claudiocapone39/Buck_Converter_20V_5V/README.md

# Synchronous Buck Converter 10-20V to 5V

This Synchronous Buck converter takes 10-20V range as input voltage and outputs 5A@5V. 
It features an LCD screen to show information and a user button to interact with the device.
The board features an LPC1313 NXP Microcontroller in addition with a buffer stage and RC filter for noise attenuation.

Buck_Converter_PCB_isometric

Buck_Converter_Block_Schematic

<br>

## SIMETRIX
  
  The converter has been simulated through the use of SIMETRIX software. 
  In this schematic, the PWM signals from the MCUs have been implemented as ideal pulse generators (INA and INB)
  
  <br>
  
  Buck_Converter_Synchronous_20V_Simetrix

  <br>

  - UCC27282 is the Gate Driver of the MOSFETs RSS065N06HZG
  - LP38691 is the LDO that outputs 3.3V
  - OPA827 works both as a buffer for the voltage divider signal and as an RC filter

The output of the buck converter, after a short transient, gets stable at 5V.

<br>

Buck_Converter_VOUT

<br>

The output of the op-amp is the voltage reference for the MCU's ADC. After a short transient, it gets stable at 3.3V

Buck_Converter_X1-OUT

<br>

The converter's efficiency has been evaluated as the ratio between output and input power.

<br>

Buck_Converter_Efficiency_report

## PCB
The PCB has been designed in Autodesk Fusion 360


Buck_Converter_PCB_top
Buck_Converter_PCB_bottom
