claudiocapone39/Buck_Converter_20V_5V/images/Buck_Converter_PCB_top.png

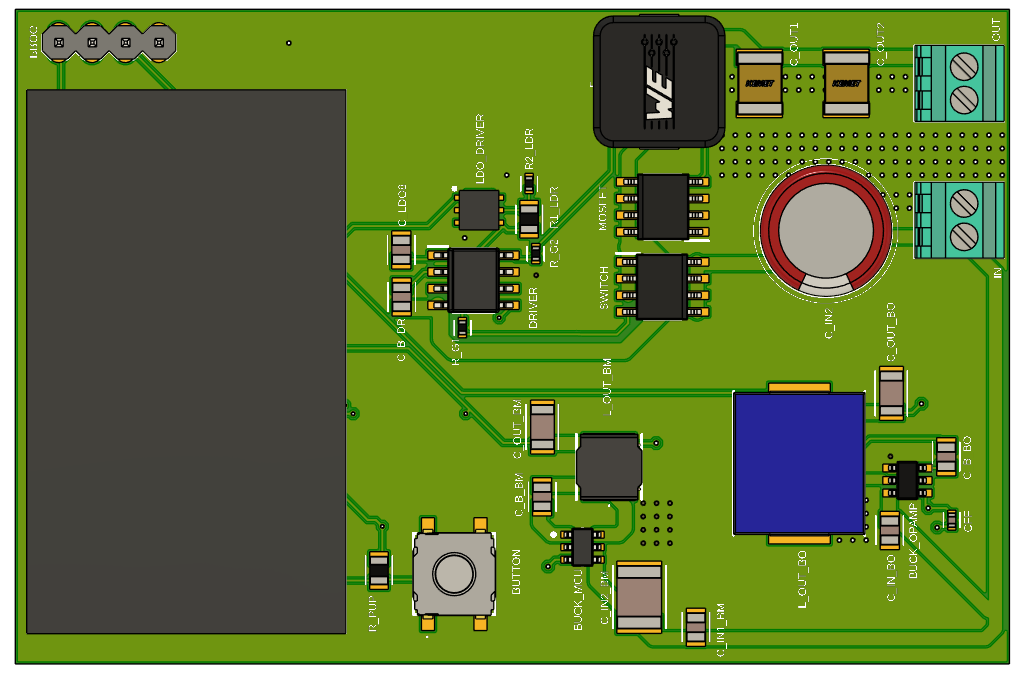
images/Buck_Converter_PCB_top.png
