claudiocapone39/Buck_Converter_20V_5V/images/Buck_Converter_Synchronous_20V_Simetrix.png

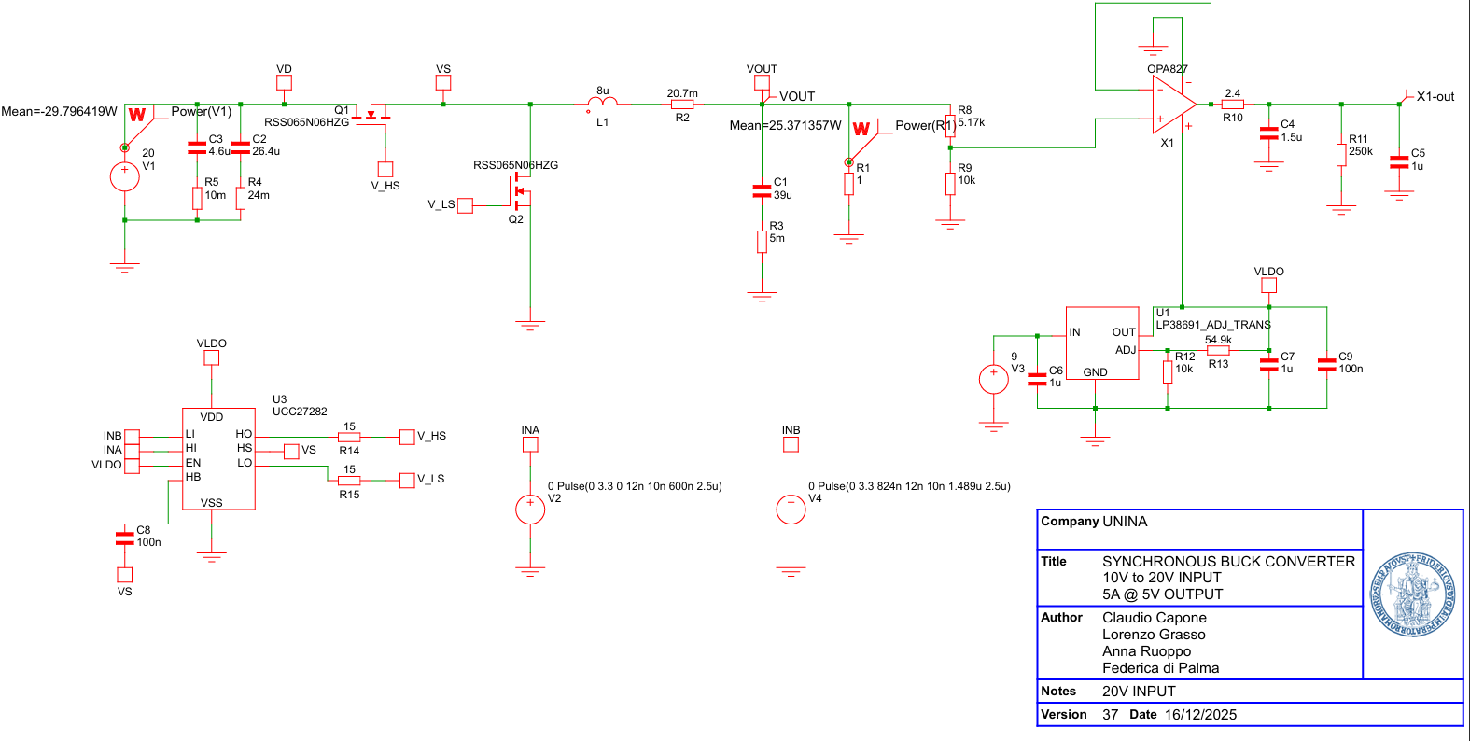
images/Buck_Converter_Synchronous_20V_Simetrix.png
