claudiocapone39/Buck_Converter_20V_5V/images/Buck_Converter_VOUT.png

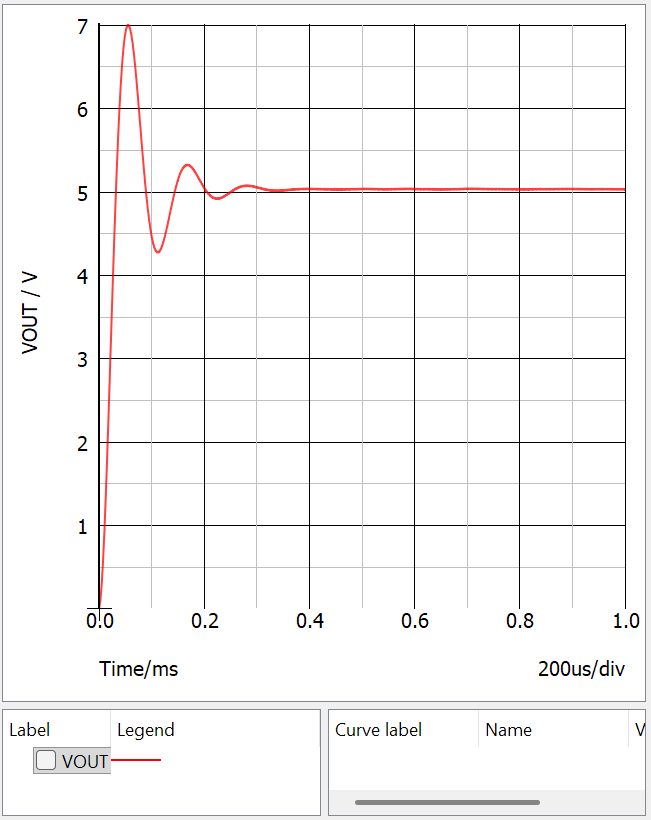
images/Buck_Converter_VOUT.png
