claudiocapone39/Buck_Converter_20V_5V/images/Buck_Converter_X1-OUT.png

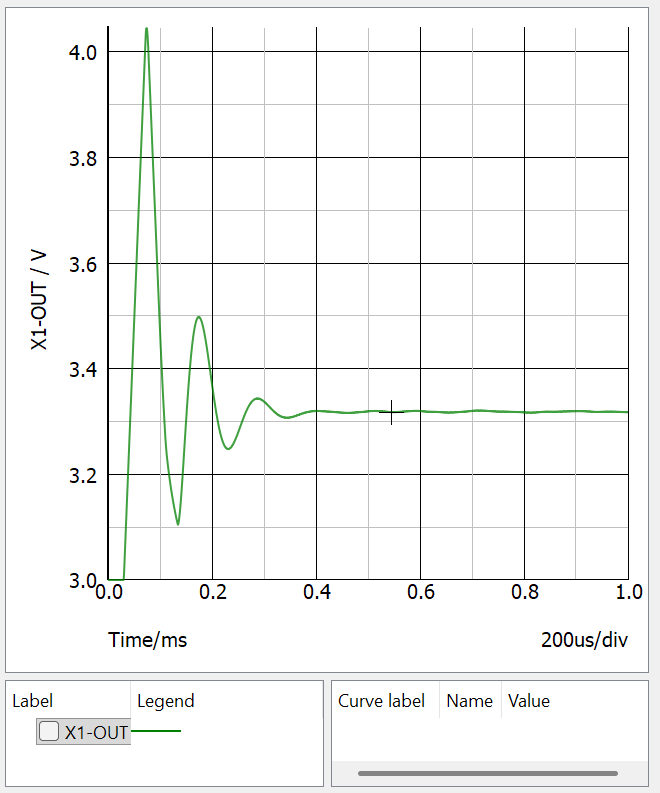
images/Buck_Converter_X1-OUT.png
