claudiocapone39/Buck_Converter_20V_5V/images/Fusion_Schematic/BUCK.png

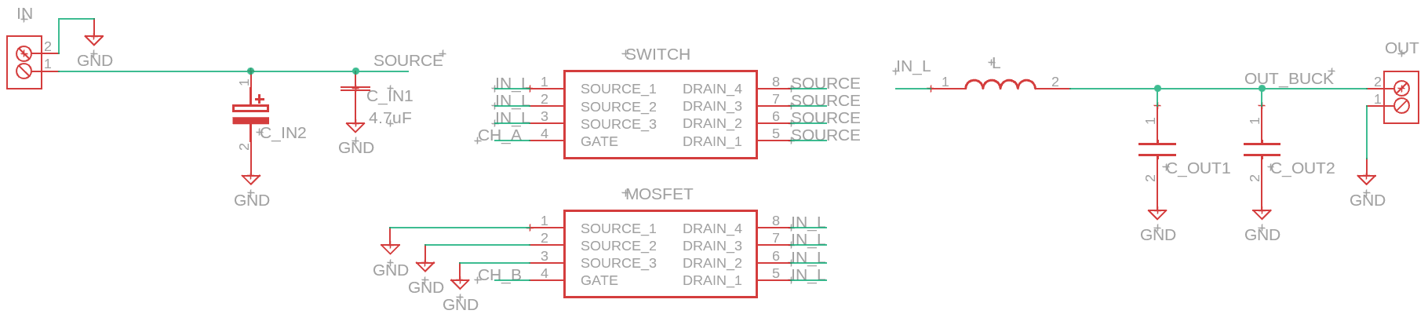
images/Fusion_Schematic/BUCK.png
