claudiocapone39/Buck_Converter_20V_5V/images/Fusion_Schematic/OPAMP.png

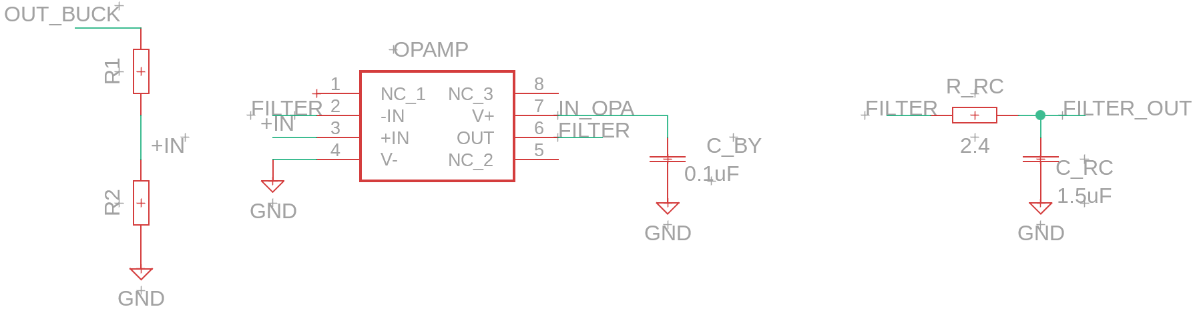
images/Fusion_Schematic/OPAMP.png
