claudiocapone39/Buck_Converter_20V_5V/BOM/BUCK_BOM.xlsx

PART NUMBER | INFO | CATEGORY | VALUE | TOLLERANCE | R | MATERIAL | QUANTITY | SELLER | PRICE
744331000 (https://www.mouser.it/ProductDetail/EPCOS-TDK/B82559B7103A016?qs=hWgE7mdIu5T7T698J9srCw%3D%3D) | Power inductor | INDUCTOR | L=10uH | NA | 20.7 mΩ | Ferite Core | 1 | Mouser | 3.61 €
RSS065N06HZGTB (https://www.mouser.it/ProductDetail/ROHM-Semiconductor/RSS065N06HZGTB?qs=XAiT9M5g4x%252BYRKVmXrwbMA%3D%3D) | Switching Mosfet | MOSFET | Id=6.5 A, Vds=60V | N.A. | 37mΩ | Silicon | 2 | Mouser | 1.78 €
C1812C206K3RLCAUTO (https://www.mouser.it/ProductDetail/KEMET/C1812C206K3RLCAUTO?qs=W%2FMpXkg%252BdQ4s7ay3ZQXJwQ%3D%3D) | Output Capacitor | CAPACITOR | C=20 uF | 10% | low ESR | Ceramic | 2 | Mouser | 3.95 €
C1812J475K5RACAUTO (https://www.mouser.it/ProductDetail/KEMET/C1812J475K5RACAUTO?qs=1Kr7Jg1SGW%252B18uJQlTRv8w%3D%3D) | Input Capacitor | CAPACITOR | C=4.7uF | 0.1 pF | low ESR | Ceramic | 1 | Mouser | 1.47 €
870235675002 (https://www.mouser.it/ProductDetail/Wurth-Elektronik/870235675002) | Input Capacitor | CAPACITOR | C=33uF | 20% | 24mΩ | Alluminum Electrolytic | 1 | Mouser | 1.08 €
TE 282834-2 (https://it.rs-online.com/web/p/morsetti-pcb/7100104?cm_mmc=aff2-_-it-_-octopart-_-7100104-_-instock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) | Morsettiera 2 pin | CONNECTOR | Vmax=150V, Imax=10A |  |  |  | 2 | RS | 2.60 €
 |  |  |  |  |  |  |  |  | 14.49 €
FSV540 (https://www.mouser.it/ProductDetail/onsemi-Fairchild/FSV540?qs=bY1dm4K8r4Uyd0P0StXc%2FQ%3D%3D) | Schottky Diode | DIODE | Vrrm=40V, If=5A, Vf=474mV |  |  |  | 1 | Mouser | 0.59 € | Note: diode for asynchronous buck
https://it.rs-online.com/web/p/morsetti-pcb/7100104?cm_mmc=aff2-_-it-_-octopart-_-7100104-_-instock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
