claudiocapone39/Buck_Converter_20V_5V/BOM/MCU_BOM.xlsx

PART NUMBER | INFO | CATEGORY | NAME_PCB | VALUE | TOLLERANCE | MATERIAL | QUANTITY | SELLER | PRICE
LPC1313FHN33/01,55 (https://www.mouser.it/ProductDetail/NXP-Semiconductors/LPC1313FHN33-0155?qs=vbj%2FKoHZRAjYq%252Bs6tIYz6A%3D%3D) | Microcontroller | Microcontreller | MCU |  |  |  | 1 | Mouser | 2.34 €
KSC253J SP DELTA LFG (https://www.mouser.it/ProductDetail/CK/KSC253J-SP-DELTA-LFG?qs=i8QVZAFTkqRm%252BD28PDm3qw%3D%3D) | User button | Button | BUTTON |  |  |  | 1 | Mouser | 0.81 €
NHD-C0216CZ-NSW-BBW-3V3 (https://www.mouser.it/ProductDetail/Newhaven-Display/NHD-C0216CZ-NSW-BBW-3V3?qs=Vb5qD4CGh4k4trYjCGAWUQ%3D%3D) | User display | Display | DISPLAY |  |  |  | 1 | Mouser | 10.91 €
KGM21AR71C105KU (https://www.mouser.it/ProductDetail/KYOCERA-AVX/KGM21AR71C105KU?qs=Jm2GQyTW%2Fbg3m8NW4RQk8Q%3D%3D) | Display capacitor | Capacitor | C_VOUT_VSS | C = 1uF, 16VDC, X7R | 10% | Multilayer Ceramic MLCC | 1 | Mouser | 0.155 €
KAF21KR71E225KU (https://www.mouser.it/ProductDetail/KYOCERA-AVX/KAF21KR71E225KU?qs=Jm2GQyTW%2FbhzfSmMLMbDLw%3D%3D) | Display capacitor | Capacitor | C_C1+_C1- | C = 2.2 uF, 25VDC, X7R | 10% | Multilayer Ceramic MLCC | 1 | Mouser | 0.301 €
KAM21BR71H104JM (https://eu.mouser.com/ProductDetail/KYOCERA-AVX/KAM21BR71H104JM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) | VDD capacitor | Capacitor | C1_VDD1, C1_VDD2 | C=0.1uF, 50VDC, X7R | 5% | Multilayer Ceramic MLCC | 2 | Mouser | 0.172 €
GMJ316BB7106KLHT (https://www.mouser.it/ProductDetail/TAIYO-YUDEN/GMJ316BB7106KLHT) | VDD capacitor | Capacitor | C2_VDD1, C2_VDD2 | C = 10uF, 35VDC, X7R | 10% | Multilayer Ceramic MLCC | 2 | Mouser | 0.68€
ABLS2-12.000MHZ-D4Y-T (https://eu.mouser.com/ProductDetail/ABRACON/ABLS2-12.000MHZ-D4Y-T?qs=LoTOQoUkC8Rn80rn3Dp9%252Bw%3D%3D) | Oscillator | Oscillator | OSC | f=12 MHz, Cload=18 pF, Rs = 50 ohm |  | Crystals | 1 | Mouser | 0.327 €
0805YA390JAT2A (https://eu.mouser.com/ProductDetail/KYOCERA-AVX/0805YA390JAT2A?qs=FTSA3t3dCI45dkYBWw0oCA%3D%3D) | Oscillator capacitor | Capacitor | C1_OSC, C2_OSC | C=39 Pf, , 16VDC | 5% | Multilayer Ceramic MLCC | 2 | Mouser | 0.181 €
MCU0805MD1002BP500 (https://eu.mouser.com/ProductDetail/Vishay-Beyschlag/MCU0805MD1002BP500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) | Reset resistor Pull-up resistor | Resistor | R_RESET, R_PUP | R = 10 kOhm | 0.10% | Thin Film Resistors SMD | 2 | Mouser | 0.421 € |  | note: aggiungere nel totale r_pup
 |  |  |  |  |  |  |  |  | 16.30 €
 |  |  |  |  |  |  |  |  |  | Capacitor VDD | Note: molto vicino al pin VDD
