claudiocapone39/Buck_Converter_20V_5V/BOM/OPAMP_BOM.xlsx

PART NUMBER | INFO | CATEGORY | VALUE | TOLLERANCE | R | MATERIAL | QUANTITY | SELLER | PRICE | PCB
OPA827 (https://www.mouser.it/ProductDetail/Texas-Instruments/OPA827AID?qs=iSMark9AYDVjkY2y4BYwEw%3D%3D) | Op-Amp | OPERATIONAL | SR:28 V/µs, GBW = 22 MHz | NA | NA | NA | 1 | Mouser | 9,31 € | OPAMP
16MU155MA23216 (https://eu.mouser.com/ProductDetail/Rubycon/16MU155MA23216?qs=T3oQrply3y%2FAU%252B6L%252B4UXEA%3D%3D) | Capacitor for RC | CAPACITOR | C=1.5 uF | 20% | 37mΩ | Film Capacitors | 1 | Mouser | 3,38 € | C_RC
RK73H1ETTP2R40F (https://www.mouser.it/ProductDetail/KOA-Speer/RK73H1ETTP2R40F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) | Resistor for RC | RESISTOR | R=2.4Ohms | 1% | NA | Thick Film | 1 | Mouser | 0,101 € | R_RC
MCU0805MD1002BP500 (https://eu.mouser.com/ProductDetail/Vishay-Beyschlag/MCU0805MD1002BP500) | Voltage Divider R2 | RESISTOR | R=10 kOhms | 0,1% | NA | Thin Film Resistors | 1 | Mouser | 0,421 € | R2
RT0603DRE075K17L (https://eu.mouser.com/ProductDetail/YAGEO/RT0603DRE075K17L) | Voltage Divider R1 | RESISTOR | R=5.17 kOhms | 0,5% | NA | Thin Film Resistors | 1 | Mouser | 0,086 € | R1
KAM21BR71H104JM (https://eu.mouser.com/ProductDetail/KYOCERA-AVX/KAM21BR71H104JM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) | Bypass Capacitor V+ | CAPACITOR | C=0.1uF | 5% | lowESR | Multilayer Ceramic MLCC | 1 | Mouser | 0,172 € | C_BY
 |  |  |  |  |  |  |  |  | 13.47 €
