claudiocapone39/Buck_Converter_20V_5V/BOM/PM_BOM.xlsx

PART NUMBER | INFO | CATEGORY | NAME_PCB | VALUE | N. OUTPUTS | MATERIAL | QUANTITY | PRICE
LMR50410XFDBVR (https://www.ti.com/product/LMR50410/part-details/LMR50410XFDBVR) | Integrated Buck for MCU and display | Buck | BUCK_MCU | Vout=5V, Iout=1A, Vin=10-20V | 1 |  | 1 | 1.10 € | SCH (https://webench.ti.com/power-designer/switching-regulator/customize/22?VinMin=10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)
LP38691QSD-5.0/NOPB (https://www.mouser.it/ProductDetail/Texas-Instruments/LP38691QSD-5.0-NOPB?qs=cN01o9PeIQsdGkeHuXf4aA%3D%3D) | LDO for Amplifier, Driver, MCU, display | LDO | LDO_MCU, LDO_DISP, LDO_OPA, LDO_DRIVER | Vout=3.3V/9V, Vin= V, Iout= A | 4 |  | 2 | 1.91 €
UCC27282D (https://eu.mouser.com/ProductDetail/Texas-Instruments/UCC27282D?qs=DPoM0jnrROW6sRtyAEghOw%3D%3D) | Gate Driver | Gate Driver | DRIVER | Iout=3.5A, Vin=5.5-16V | 1 |  | 1 | 1.65 €
TPS54202DDCR (https://www.mouser.it/ProductDetail/Texas-Instruments/TPS54202DDCR?qs=uP22XH7NdCsJtN%2Fq54jCtQ%3D%3D) | Integrated Buck for Op-Amp and Driver | Buck | BUCK_OPA | Vout=9V, Iout=2A, Vin=10-20V | 1 |  | 1 | 1.00 € | SCH (https://webench.ti.com/power-designer/switching-regulator/customize/21)
BUCK_MCU_DISPLAY
C1812J475K5RACAUTO (https://www.mouser.it/ProductDetail/KEMET/C1812J475K5RACAUTO?qs=1Kr7Jg1SGW%252B18uJQlTRv8w%3D%3D) | Input Capacitor | Capacitor | C_IN2_BM | C=4.7uF, 50VDC | 0.1 pF | Ceramic | 1 | 1.47 €
KAM21BR71H104JM (https://www.mouser.it/ProductDetail/KYOCERA-AVX/KAM21BR71H104JM) | Input Capacitor and ~~B~~ootstrap Capacitor | Capacitor | C_IN1_BM, C_B_BM | C=0.1uF, 50VDC | 5% | Ceramic | 2 | 0.17 €
BWVS00505040150M00 (https://www.mouser.it/ProductDetail/Pulse-Electronics/BWVS00505040150M00?qs=DRkmTr78QARhg29ditvGew%3D%3D) | Output Inductor | Inductor | L_OUT_BM | L=15uH, R=90mOHM | 20% |  | 1 | 0.28 €
RT1206FRE0788K7L (https://www.mouser.it/ProductDetail/YAGEO/RT1206FRE0788K7L) | Output Resistor | Resistor | R_OUT1_BM | R=88.7kOHM | 1% |  | 1 | 0.14 €
RCA080522K1FKEA (https://www.mouser.it/ProductDetail/Vishay-Draloric/RCA080522K1FKEA) | Output Resistor | Resistor | R_OUT2_BM | R=22.1kOHM | 1% |  | 1 | 0.12 €
LMK316ABJ226KL-T (https://www.mouser.it/ProductDetail/TAIYO-YUDEN/LMK316ABJ226KL-T?qs=vF%252B8ahGVilev%2F2scpOQ9dg%3D%3D) | Output Capacitor | Capacitor | C_OUT_BM | C=22uF, 10VDC, X5R |  | Ceramic | 1 | 0.30 €
BUCK_OPA_DRIVER
C2012X5R1V156M125AC (https://www.mouser.it/ProductDetail/TDK/C2012X5R1V156M125AC) | Input Capacitor | Capacitor | C_IN_BO | C=15uF, 35VDC, X5R | 10% | Ceramic | 1 | 0.68 €
VJ0402A470FXXCW1BC (https://www.mouser.it/ProductDetail/Vishay-Vitramon/VJ0402A470FXXCW1BC) | CFF | Capacitor | CFF | C=47pF, 25VDC | 1% | Ceramic | 1 | 0.17 €
SRP1050WA-120M (https://www.mouser.it/ProductDetail/Bourns/SRP1050WA-120M) | Outout Inductor | Inductor | L_OUT_BO | C=12uF, 8.3A, 24mOHM | 20% |  | 1 | 0.97 €
SFR01MZPJ104 (https://www.mouser.it/ProductDetail/ROHM-Semiconductor/SFR01MZPJ104) | Output Resistor | Resistor | R_OUT1_BO | R=100kOHM | 5.00% |  | 1 | 0.11 €
RMCF0402FT7K15 (https://www.mouser.it/ProductDetail/SEI-Stackpole/RMCF0402FT7K15) | Output Resistor | Resistor | R_OUT2_BO | R=7.15kOHM | 1% |  | 1 | 0.08 €
KGM31HR51E226KU (https://www.mouser.it/ProductDetail/KYOCERA-AVX/KGM31HR51E226KU?qs=Jm2GQyTW%2FbjbfK4ZSMtgGw%3D%3D) | Output Capacitor | Capacitor | C_OUT_BO | C=22uF, 25VDC, X5R | 10% | Ceramic | 1 | 1.01 €
LDO_MCU_DISP (https://www.mouser.it/ProductDetail/Texas-Instruments/LP38691QSD-5.0-NOPB?qs=cN01o9PeIQsdGkeHuXf4aA%3D%3D)
RN73H1JTTD1642B25 (https://www.mouser.it/ProductDetail/KOA-Speer/RN73H1JTTD1642B25?qs=0hon8nwgHrbKEygnGoXdJw%3D%3D) | Resistenza R1 feedback | Resistor | R1_LM, R1_DI | R=16.4kOhm | 0.10% |  | 1 | 0.20 €
CRCW040210K0FHEDP (https://www.mouser.it/ProductDetail/Vishay/CRCW040210K0FHEDP?qs=sGAEpiMZZMtlubZbdhIBIIjtErb0OzfHXC2ctQbbyhM%3D) | Resistenza R2 feedback | Resistor | R2_LM, R2_DI | R=10kOhm | 1% |  | 1 | 0.20 €
LDO_OPA_DRIVER
7-2176093-0 (https://www.mouser.it/ProductDetail/TE-Connectivity-Holsworthy/7-2176093-0?qs=aCf%252BRoEN5JMAJ5oW5HKUlg%3D%3D) | Resistenza R1 feedback | Resistor | R1_LO, R1_LDR | R=54.9kOhm | 0.10% |  | 1 | 0.20 €
CRCW040210K0FHEDP (https://www.mouser.it/ProductDetail/Vishay/CRCW040210K0FHEDP?qs=sGAEpiMZZMtlubZbdhIBIIjtErb0OzfHXC2ctQbbyhM%3D) | Resistenza R2 feedback | Resistor | R2_LO, R2_LDR | R=10kOhm | 1.00% |  | 1 | 0.20 €
LDO
MCASG21GSB7105KTNA01 (https://www.mouser.it/ProductDetail/TAIYO-YUDEN/MCASG21GSB7105KTNA01?qs=tlsG%2FOw5FFhIRV3mRKoR1g%3D%3D) | Condensatore input e output per LDOs | Capacitor | C_LDO | C=1uF, 35VDC, X7R | 10% | Ceramic | 8 | 0.16 €
DRIVER
SFR01MZPJ150 (https://www.mouser.it/ProductDetail/ROHM-Semiconductor/SFR01MZPJ150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) | Resistenza di Gate | Reistor | R_G | 15OHM | 5% |  | 2 | 0.10 €
KAM21BR71H104JM (https://www.mouser.it/ProductDetail/KYOCERA-AVX/KAM21BR71H104JM) | ~~B~~ootstrap Capacitor | Capacitor | C_IN1_BM, C_B_BM | C=0.1uF, 50VDC | 5% | Ceramic | 1 | 0.17 €
MLAST105SB5105KFNA01 (https://www.mouser.it/ProductDetail/TAIYO-YUDEN/MLAST105SB5105KFNA01) | Bypass Capacitor | Capacitor | C_BY_D | C=1uF, 25VDC, X5R | 10% | Ceramic | 1 | 0.14 €
 |  |  |  |  |  |  |  | 12.53 €
