claudiocapone39/Buck_Converter_20V_5V/Simulations/LTSPICE/BUCK.asc

C1: cap; 4.6µ
C2: cap; 26.4µ
C3: cap; 39µ
L1: ind; 8µ
R1: res; 10m
R2: res; 24m
R3: res; 20.7m
R4: res; 5m
R_LOAD: res; 1
U1: RSS065N06HZG
U2: RSS065N06HZG
V1: voltage; 20
V2: voltage; PULSE(0 20 0 12n 10n 614n 2.5u 400k)
V3: voltage; PULSE(0 20 824n 12n 10n 1.489u 2.5u 400k)
Named nets: 0
.meas TRAN E_SW_RISE_1 INTEG (V(N001)-V(N002))*Ix(U1:D) FROM 1.45750262m TO 1.45750871m
.tran 0 3m 0 10n
.meas TRAN E_SW_FALL_1 INTEG (V(N001)-V(N002))*Ix(U1:D) FROM 1.45816208m TO 1.45817578m
.meas TRAN E_SW_RISE_2 INTEG V(N002)*Ix(U2:D) FROM 1.457503313m TO 1.457509817m
.meas TRAN E_SW_FALL_2 INTEG V(N002)*Ix(U2:D) FROM 1.457506612m TO 1.457509568m
.meas TRAN E_SW_RISE_1_TOT INTEG V(N001)*Ix(U1:D)+V(N008)*Ix(U1:G)+V(N002)*Ix(U1:S) FROM 1.45750262m TO 1.45750871m
.meas TRAN E_SW_FALL_1_TOT INTEG V(N001)*Ix(U1:D)+V(N008)*Ix(U1:G)+V(N002)*Ix(U1:S) FROM 1.45816208m TO 1.45817578m
.meas TRAN_E_SW_RISE_2_TOT INTEG V(N002)*Ix(U2:D)+V(N005)*IX(U2:G) FROM 1.457503313m TO 1.457509817m
.meas TRAN_E_SW_FALL_2_TOT INTEG V(N002)*Ix(U2:D)+V(N005)*Ix(U2:G) FROM 1.457504323m TO 1.457509568m
